JomDupaya/Robotics_Sumobot/Assets/Images/Bot_photo2.jpg

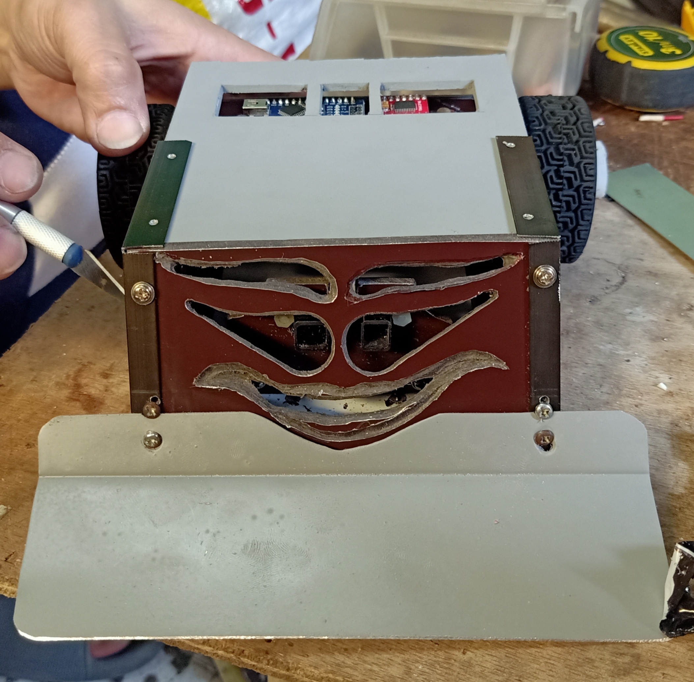
Assets/Images/Bot_photo2.jpg
