JomDupaya/Robotics_Sumobot/Docs/PCB layout.jpg

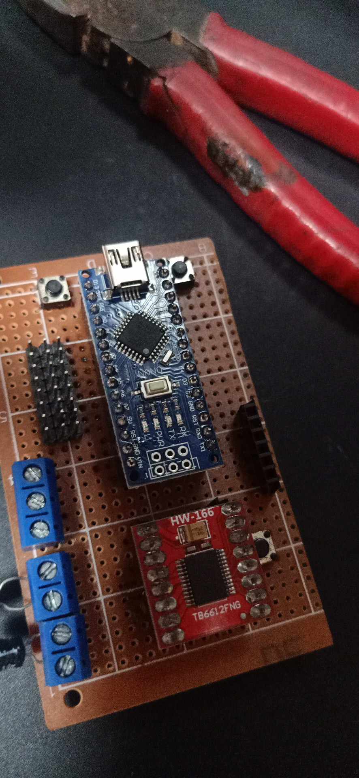
Docs/PCB layout.jpg
