JomDupaya/Robotics_Sumobot/Assets/README.md

# Project Assets

This repository includes various images and media files that support and complement the content of the project. These assets may include diagrams, illustrations, and screenshots to help with understanding the concepts, components, and steps involved in the project.

## 📂 Usage

You can view or download the assets from the `Assets/` directory. These resources are meant to assist in visualizing the project’s structure and implementation.

## 📜 License

The images and media files are provided under the same [MIT License](https://github.com/JomDupaya/Robotics_Sumobot/blob/e8f7132bed7ddc537f46a0e22422b6b8f175e030/LICENSE) as the project itself.

If you have any questions or need further assistance, feel free to reach out!
