JomDupaya/Robotics_Sumobot/Assets/Images/Bot_photo1.jpg

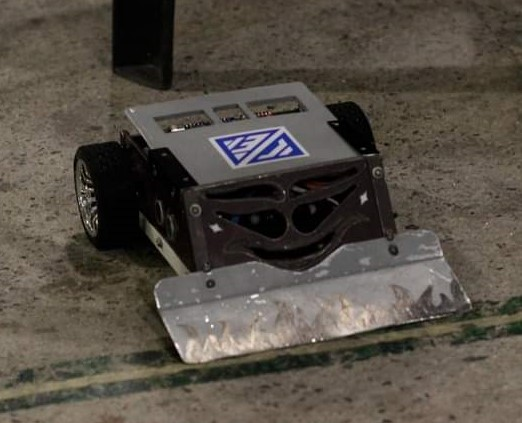
Assets/Images/Bot_photo1.jpg
