JomDupaya/Robotics_Sumobot/Assets/Images/Schematic Diagram_Sumobot.png

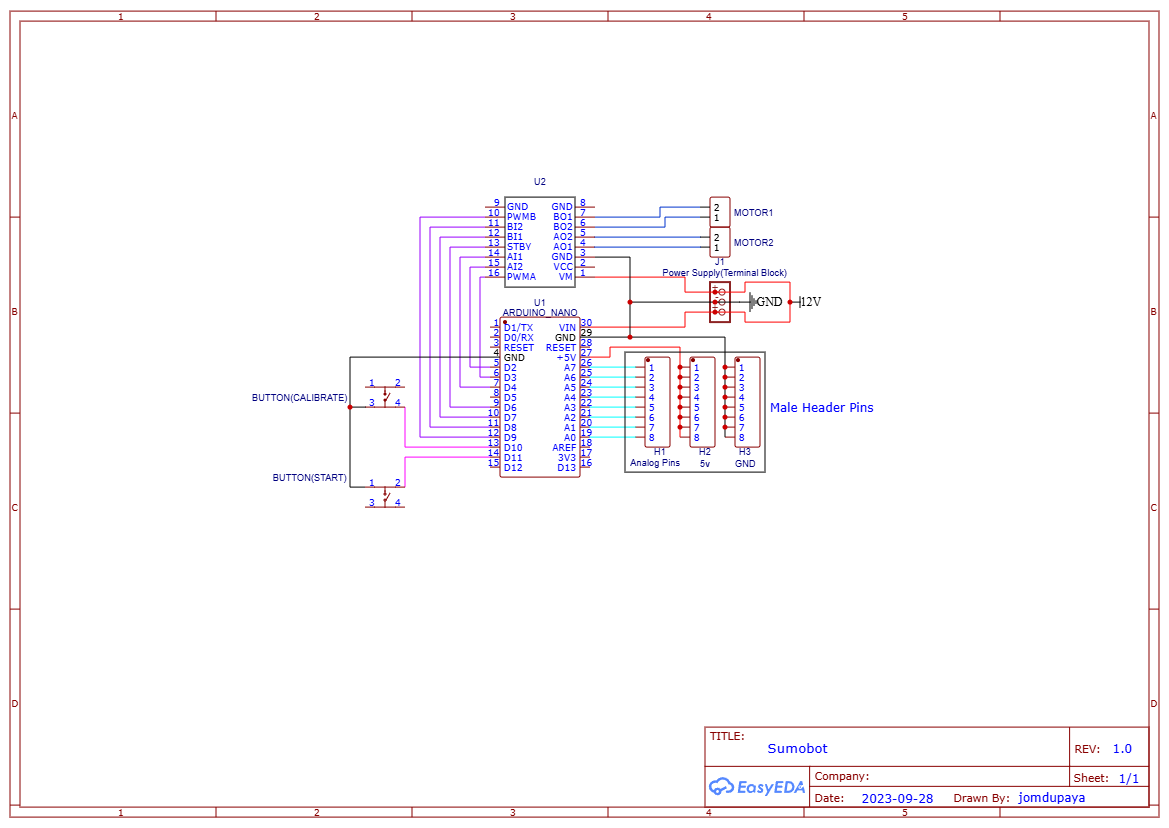
Assets/Images/Schematic Diagram_Sumobot.png
