JomDupaya/Robotics_Sumobot/Assets/Images/Sumobot Layout.jpg

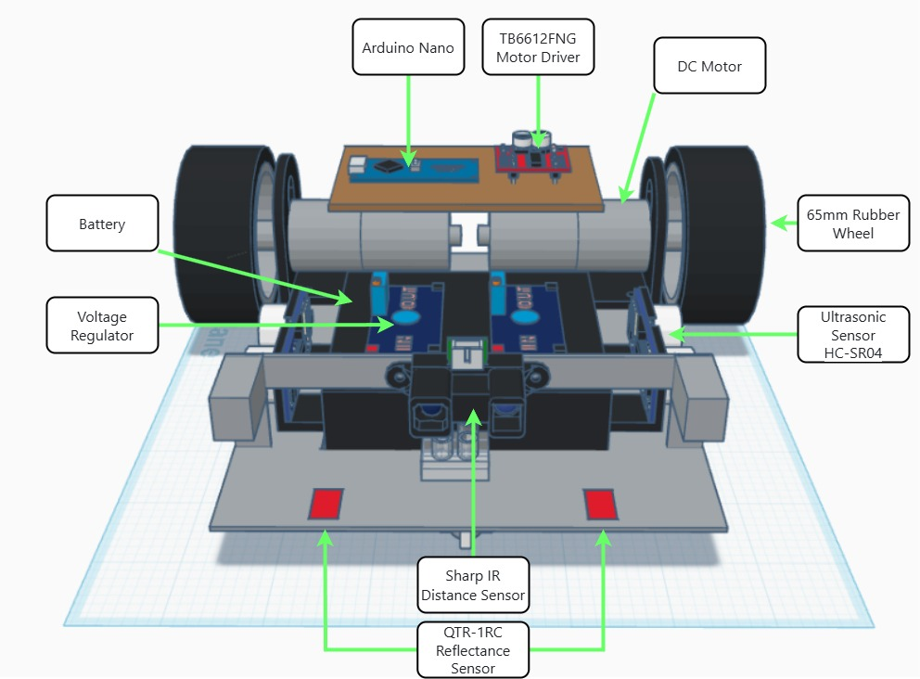
Assets/Images/Sumobot Layout.jpg
