JomDupaya/Robotics_Sumobot/Docs/SumobotDrawing1.pdf

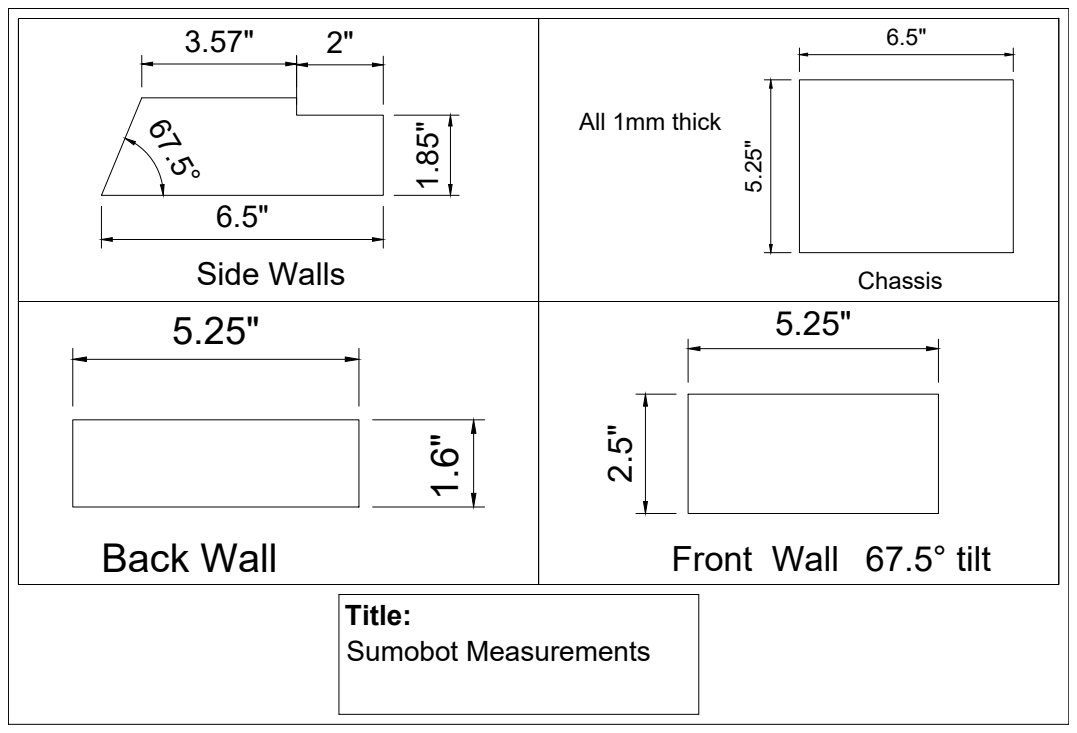
[picture p6: page 1]
All 1mm thick 5.25"; Side Walls; Back Wall; Sumobot Measurements

Front Wall 67.5° tilt
