JomDupaya/Robotics_Sumobot/Docs/SumobotDrawing2.pdf

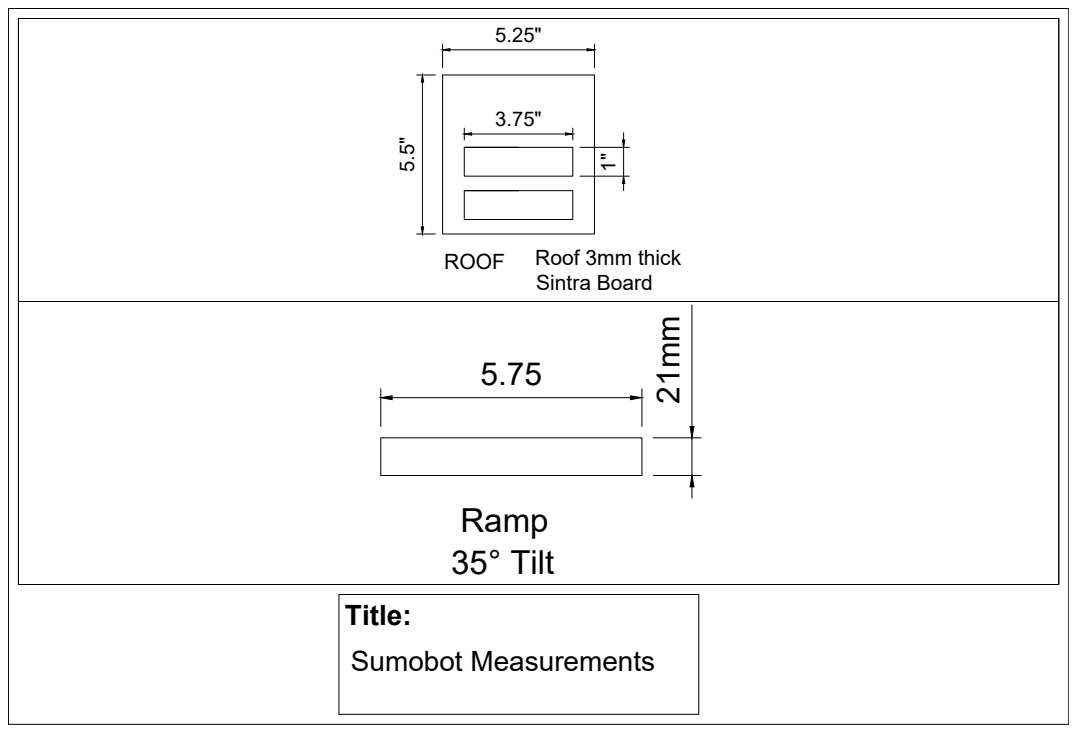
[picture p7: page 1]
35° Tilt; ROOF; Roof 3mm thick; Sintra Board 5.5"; Sumobot Measurements
